Pasgid/drone-projects/SimpleFC_Brushed/pcb/copper_preview.png

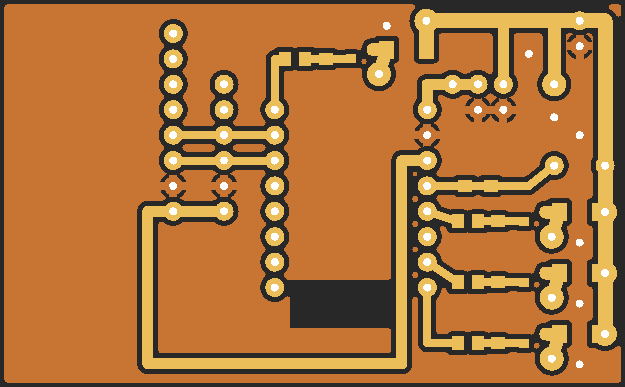
SimpleFC_Brushed/pcb/copper_preview.png
