Pasgid/drone-projects/(commit log)

2026-10-26 Initial commit: ESP32 flight controller and transmitter projects
2026-11-02 Add GPS, RTH and heading hold to FlightController; fix ALT HOLD
    FlightController:
    - Add GPS (UBX) and compass, GPS position hold, return to home and
    heading hold.
    - ALT HOLD holds at mid stick and engages from the first takeoff.
    - When the rangefinders disagree, stop using the shorter reading.
    - Add a SETUP > ALT HOLD > EST BLEND S setting, default 0.4 s (was a
    fixed 0.8 s). The speed estimate read about 37 % of real speed and
    the height bounced; flights since hold within about 3-5 cm rms.
    - Log vertical acceleration, its offset, speed estimate, target height
    and VEL I correction in the flight recorder.
    Transmitter2:
    - Add simulator mode as a BLE gamepad.
    - Hold the button 2 s while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
    [FlightController.ino, Transmitter2.ino]
2026-11-12 Add WIRING.md with pinout pictures for every board
    docs/make_pinouts.py draws one pinout SVG per board (pins taken from the
    sketches) plus the motor layout. Also adds the SimpleFC_Brushed shield PCB
    files and wiring diagram.
2026-11-12 Commit all current work: firmware updates, flight logs, new sketches
    - SimpleFC / SimpleFC_Brushed: alt hold engage and hold-zone work, recorder
    columns; Brushed: serial config, no OLED, passive buzzer, MS5611, 2S defaults
    - SimpleTX, Transmitter2, NodeMCU FC updates
    - Flight logs and analysis scripts (SimpleFC/flights, SimpleFC_Brushed/flights)
    - New: SensorTest, BikeSpeedo, Drone setup (KiCad)
    [Drone setup.kicad_pcb, Drone setup.kicad_sch, flight_20261026_0845.csv, flight_20261026_1250.csv, flight_20261028_1307.csv, flight_20261028_1317.csv, flight_20261104_1734.csv, flight_20261104_1758.csv]
2026-11-12 Add animated setup guide GIF for SimpleFC_Brushed
    docs/make_setup_gif.py renders 9 step cards (wiring crops, motor layout,
    serial commands) with headless Edge/Chrome and joins them with Pillow.
    Shown at the top of WIRING.md.
2026-11-12 Add setup guide GIFs for SimpleTX + SimpleFC, Transmitter2 and the C3 Zero FC
    make_setup_gif.py now builds all four guides (OLED and serial mock-ups,
    wiring crops). Transmitter2 switch labels now match its flight-mode use.
